barajasalfredo13/Cookie.Board.Variants/README.md

# Cookie Board Variants  
This is a subiteration of the cookie board design
Stencils were made to create protected layers  

⚠️ PCB Dimensions ⚠️  
- 0.8 mm Thickness  
::: ZIP Gerber Dimensions :::  
- Full Board Stencil Dimensions ::: [x; 61.034 y; 45.501] mm  
- Full Board Cookie Dimensions ::: [x; 40.6 y; 46.15] mm  

### ::: Base of the Cookie Board ::: ###  
-6x6 mm pad  
-0.5 mm and 1.0 mm graphic for trace displacement and design  
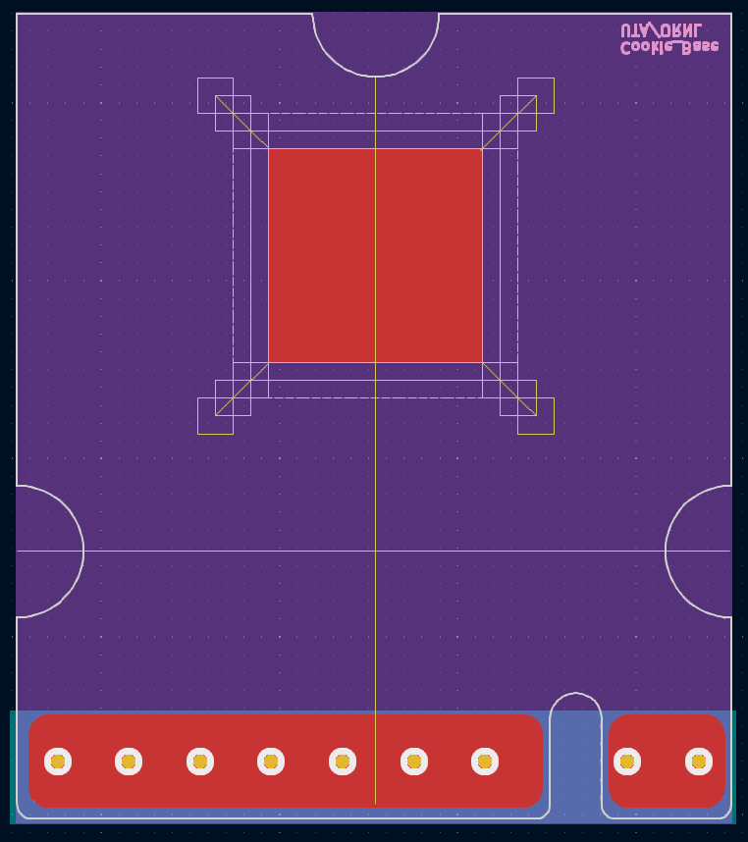
[picture p1: ReadMeImages/BoardBase.png]
 
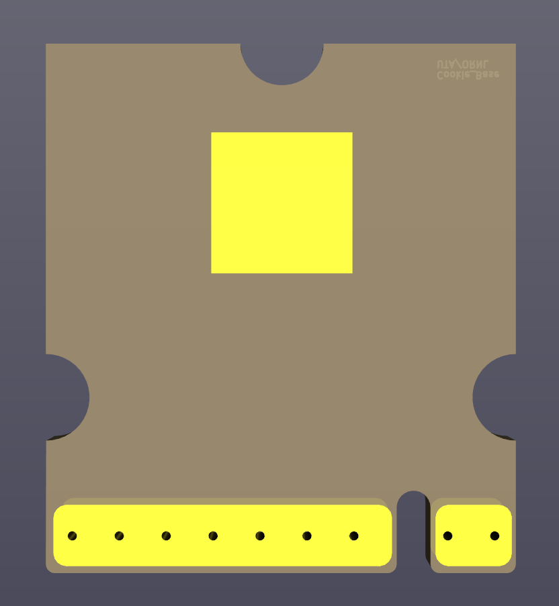
[picture p2: ReadMeImages/BoardBase2.png]
  

### ::: Variants of the Board ::: ###  
-All Boards 1.0 mm distance from pad  
-0.5 and 1.0 mm trace thickness variations  
-Square and L Variation  
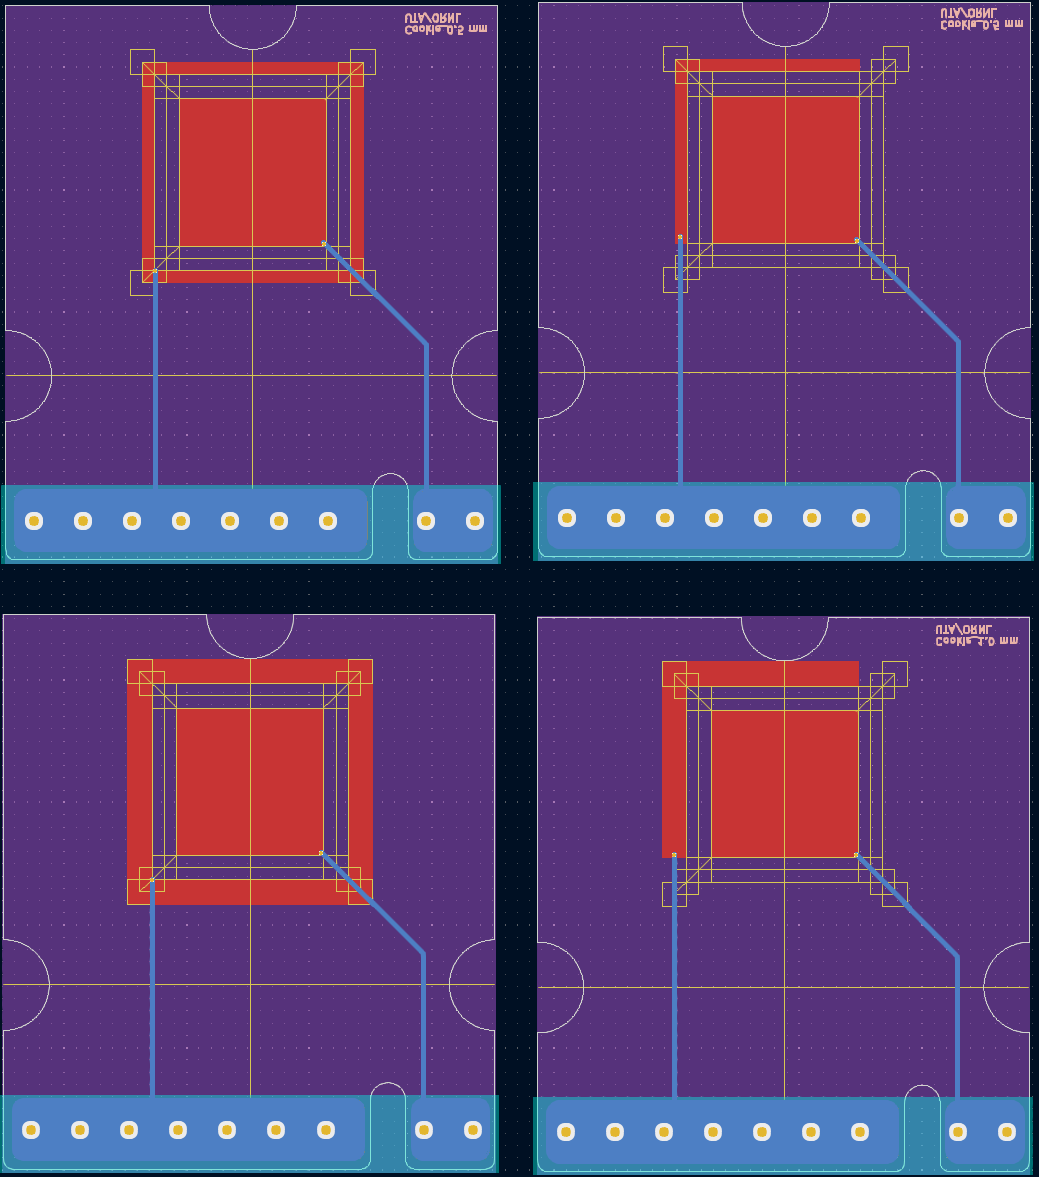
[picture p3: ReadMeImages/BoardVar.png]
 

### ::: PCB Stencils ::: ###  
-Stencils for coating were created per board variation  
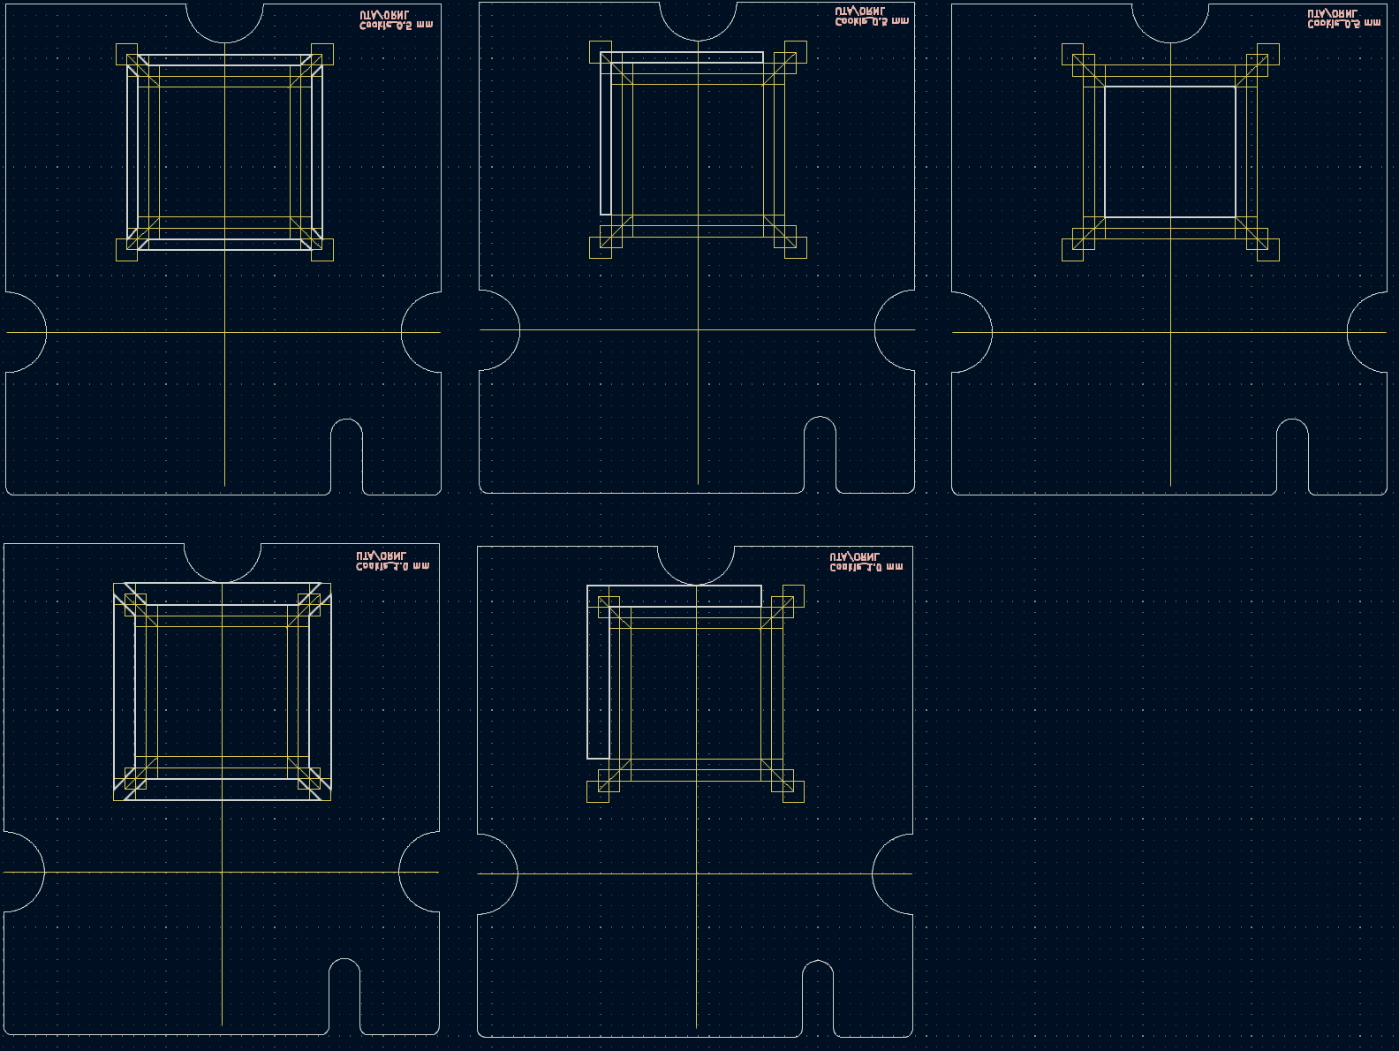
[picture p4: ReadMeImages/KiCadStencils1.png]
 
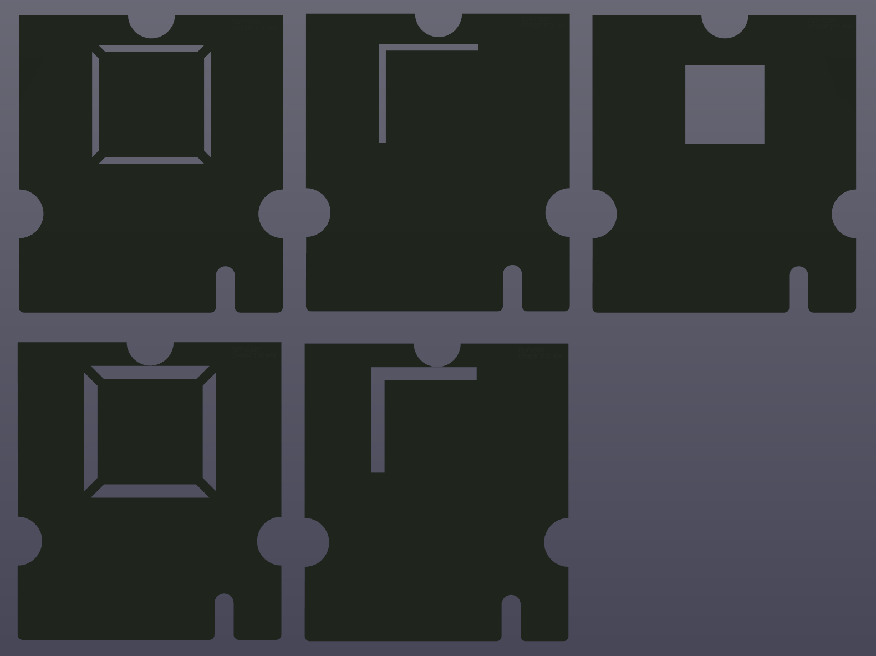
[picture p5: ReadMeImages/KiCadStencils2.png]
 
  
### ::: Sheet Metal Stencils ::: ###  
-Sheet Metal stencils were using PCB Step Files  
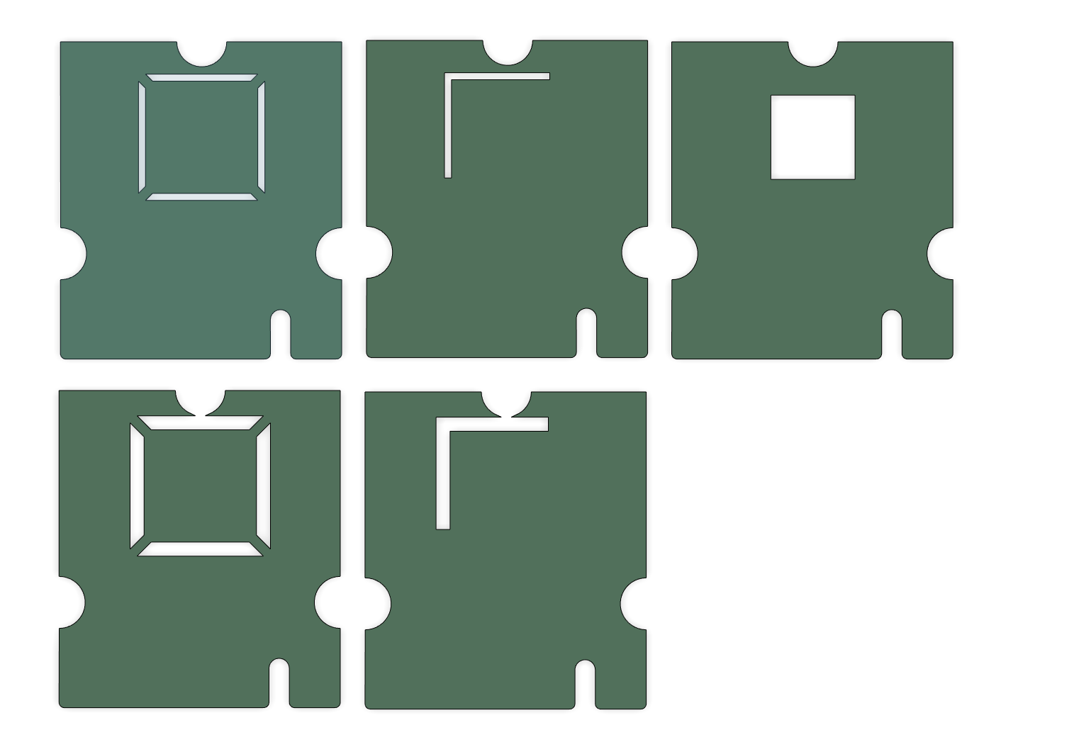
[picture p6: ReadMeImages/FusionStencils.png]
  
  
### ::: Stencil Holder ::: ###  
-Stencil Holder is used with PCB Stencils or Sheet Metal Stencils  
-2 Stencil Holders were made, one with wiggle room (gray) one with PCB Step Files (Green)  
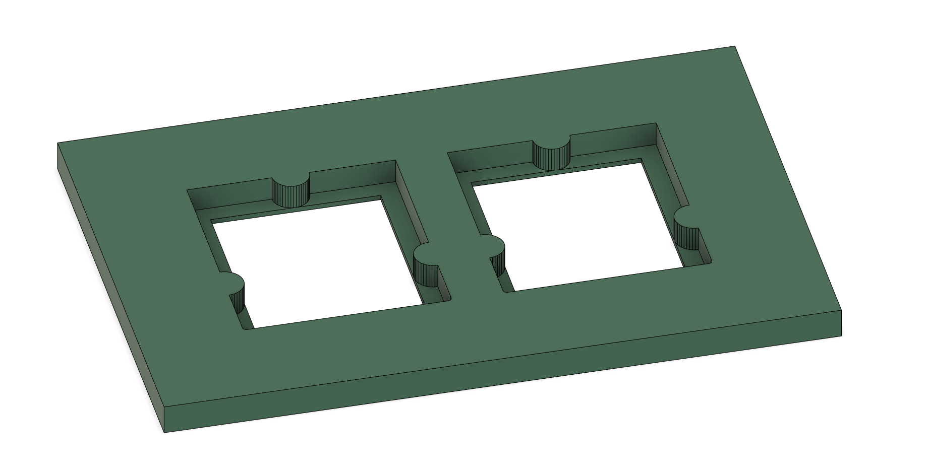
[picture p7: ReadMeImages/StencilHolder1.png]
  
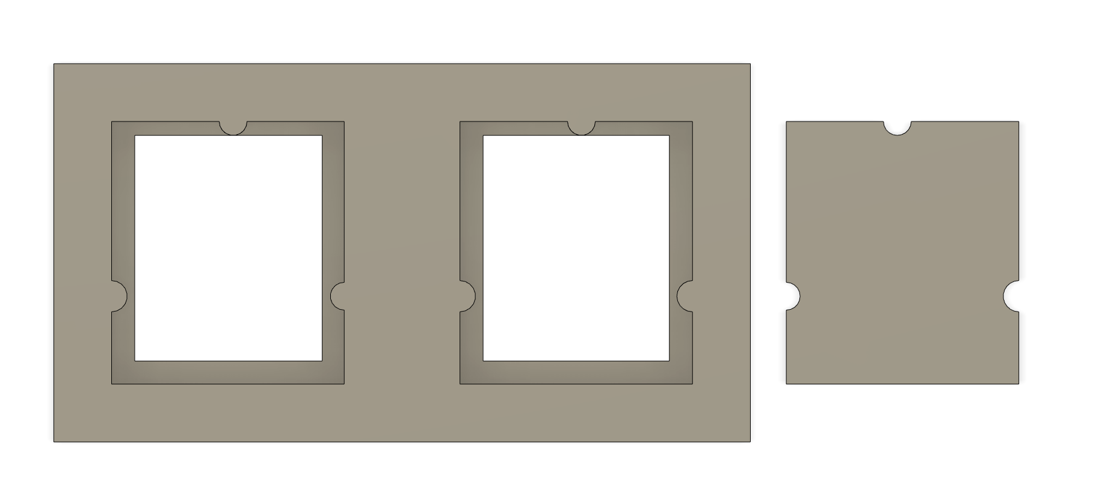
[picture p8: ReadMeImages/StencilHolder2.png]
