barajasalfredo13/Cookie.Board.Variants/ReadMeImages/MetalStencil.png

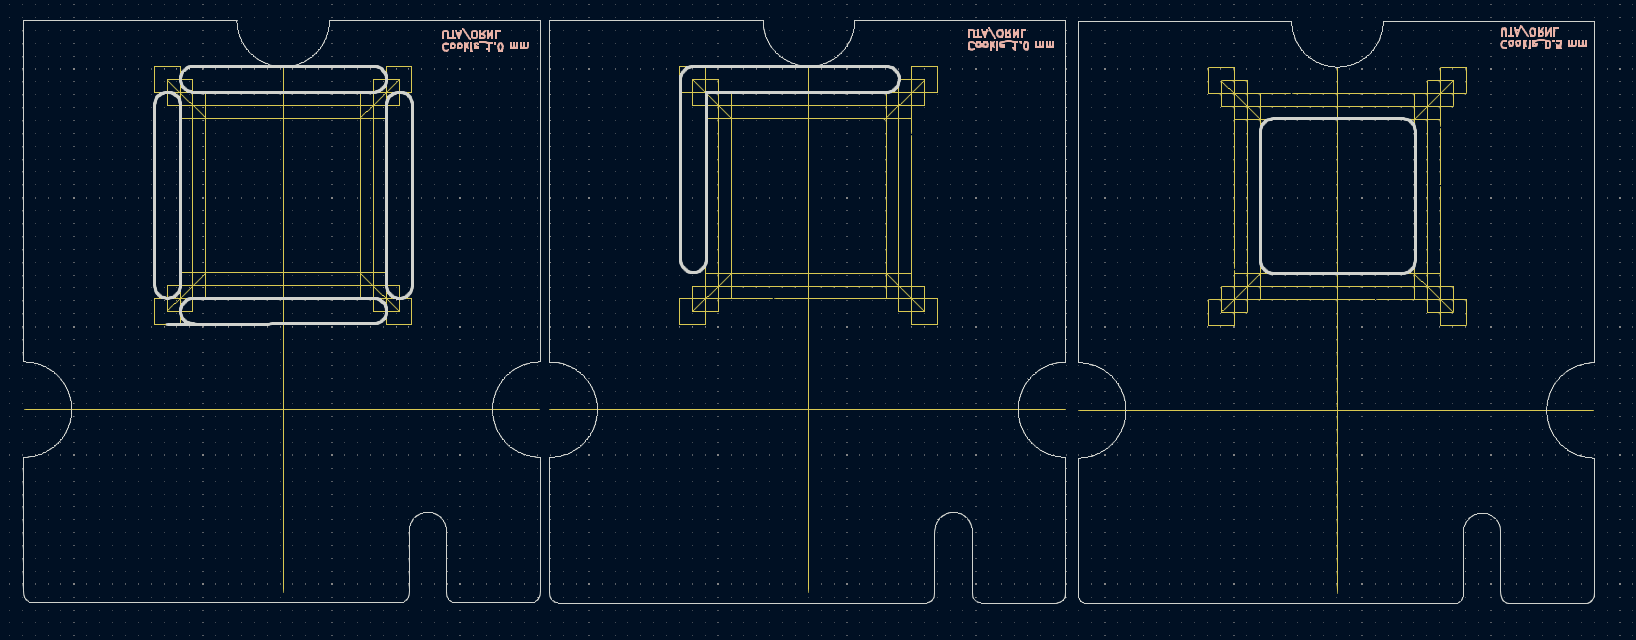
ReadMeImages/MetalStencil.png
