barajasalfredo13/Cookie.Board.Variants/ReadMeImages/StencilAddedMass.png

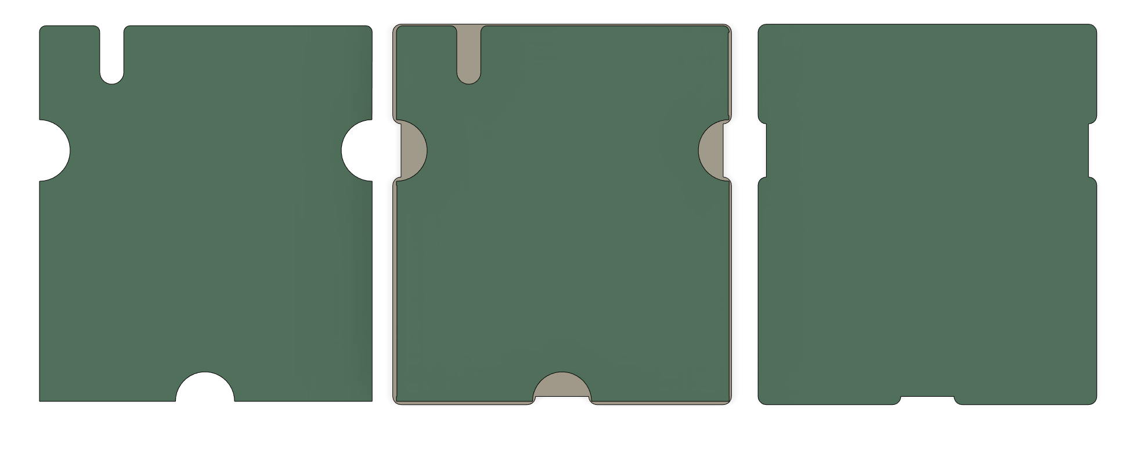
ReadMeImages/StencilAddedMass.png
