barajasalfredo13/Cookie.Board.Variants/4.DXF.Files/StencilHolder.dxf

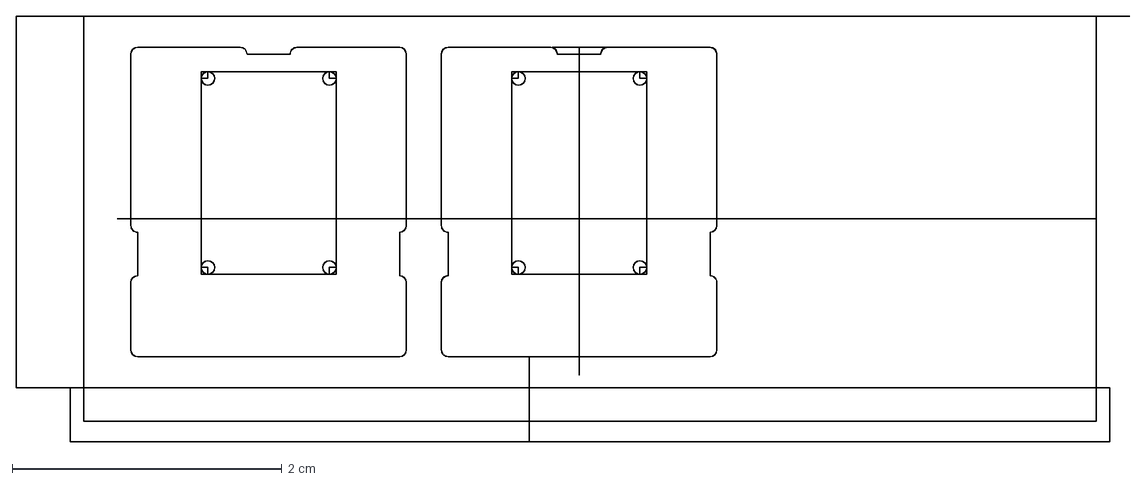
[picture p11: CAD file, 2023-04-19]
4.DXF.Files/StencilHolder.dxf
8.25 x 3.15 cm
