barajasalfredo13/Cookie.Board.Variants/4.DXF.Files/Cookie.Singlets.dxf

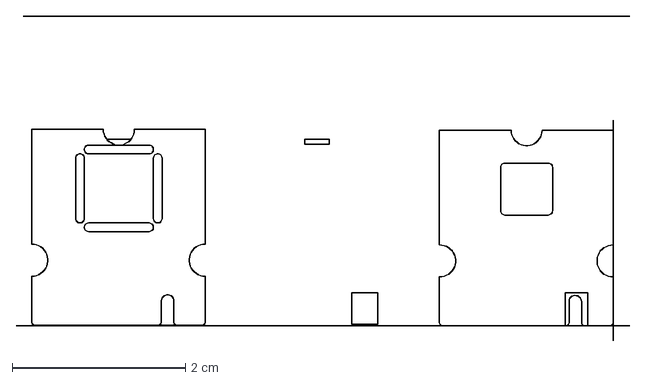
[picture p12: CAD file, 2023-04-19]
4.DXF.Files/Cookie.Singlets.dxf
7.08 x 3.75 cm
