barajasalfredo13/Cookie.Board.Variants/(list of files, cad)

Other CAD files:
2.Fusion360Files/1.Stencil.Holder/StencilHolder.f3d
2.Fusion360Files/2.Singlet.Stencils/Cookie_Singlets.f3d
