barajasalfredo13/Cookie.Board.Variants/2.Fusion360Files/2.Singlet.Stencils/SingletStencilsImperial.pdf

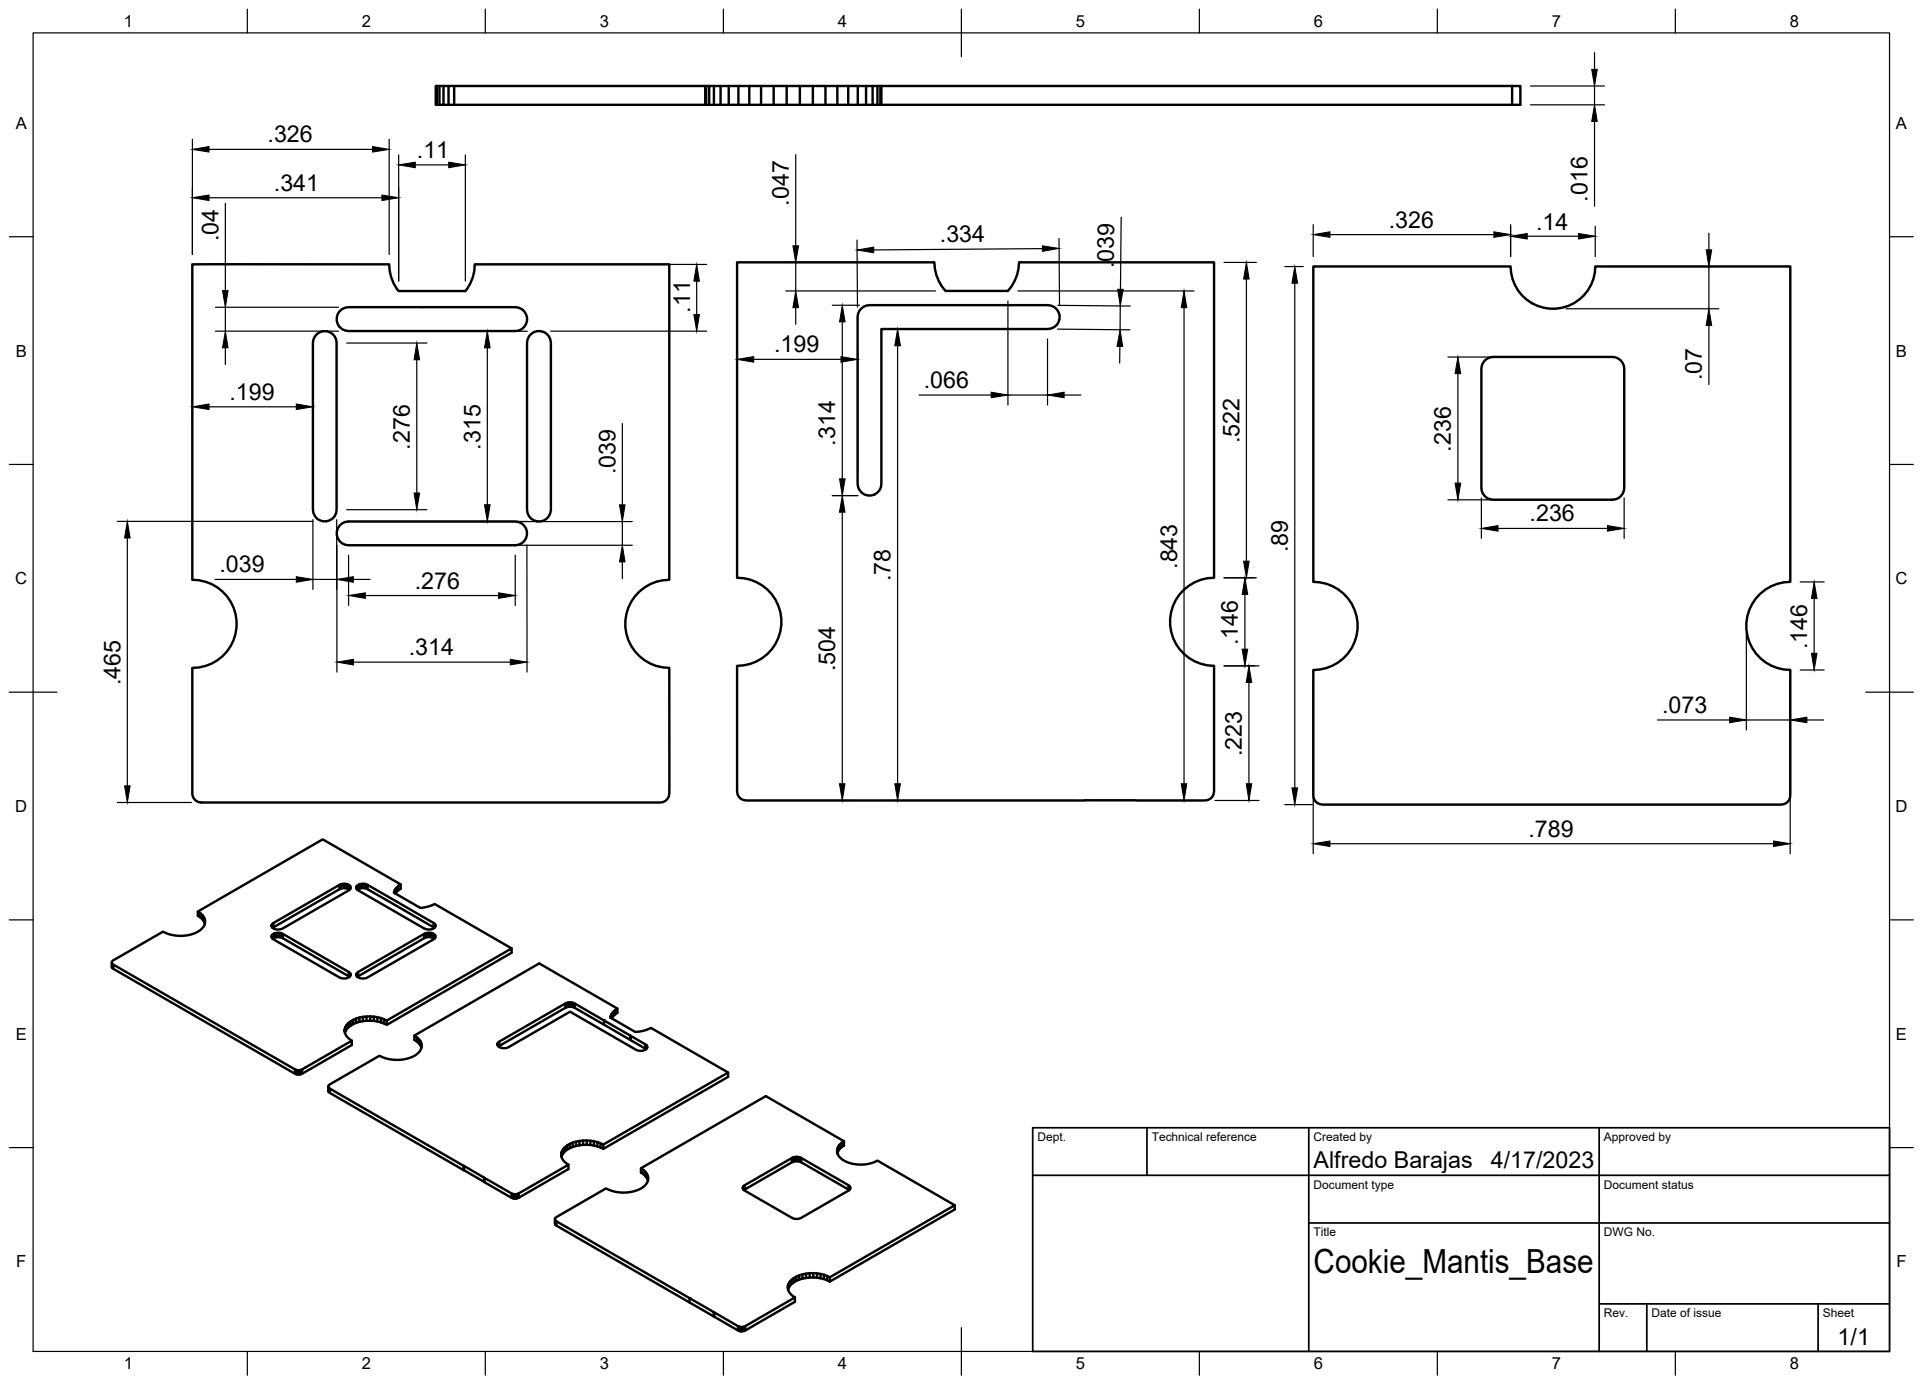
[picture p13: page 1]
Title; DWG No.; Rev.; Date of issue; Sheet

Dept. | Technical reference | Created by Alfredo Barajas 4/17/2023 | Approved by

Document type | Document status
