barajasalfredo13/Cookie.Board.Variants/2.Fusion360Files/1.Stencil.Holder/StencilHolderImperial.pdf

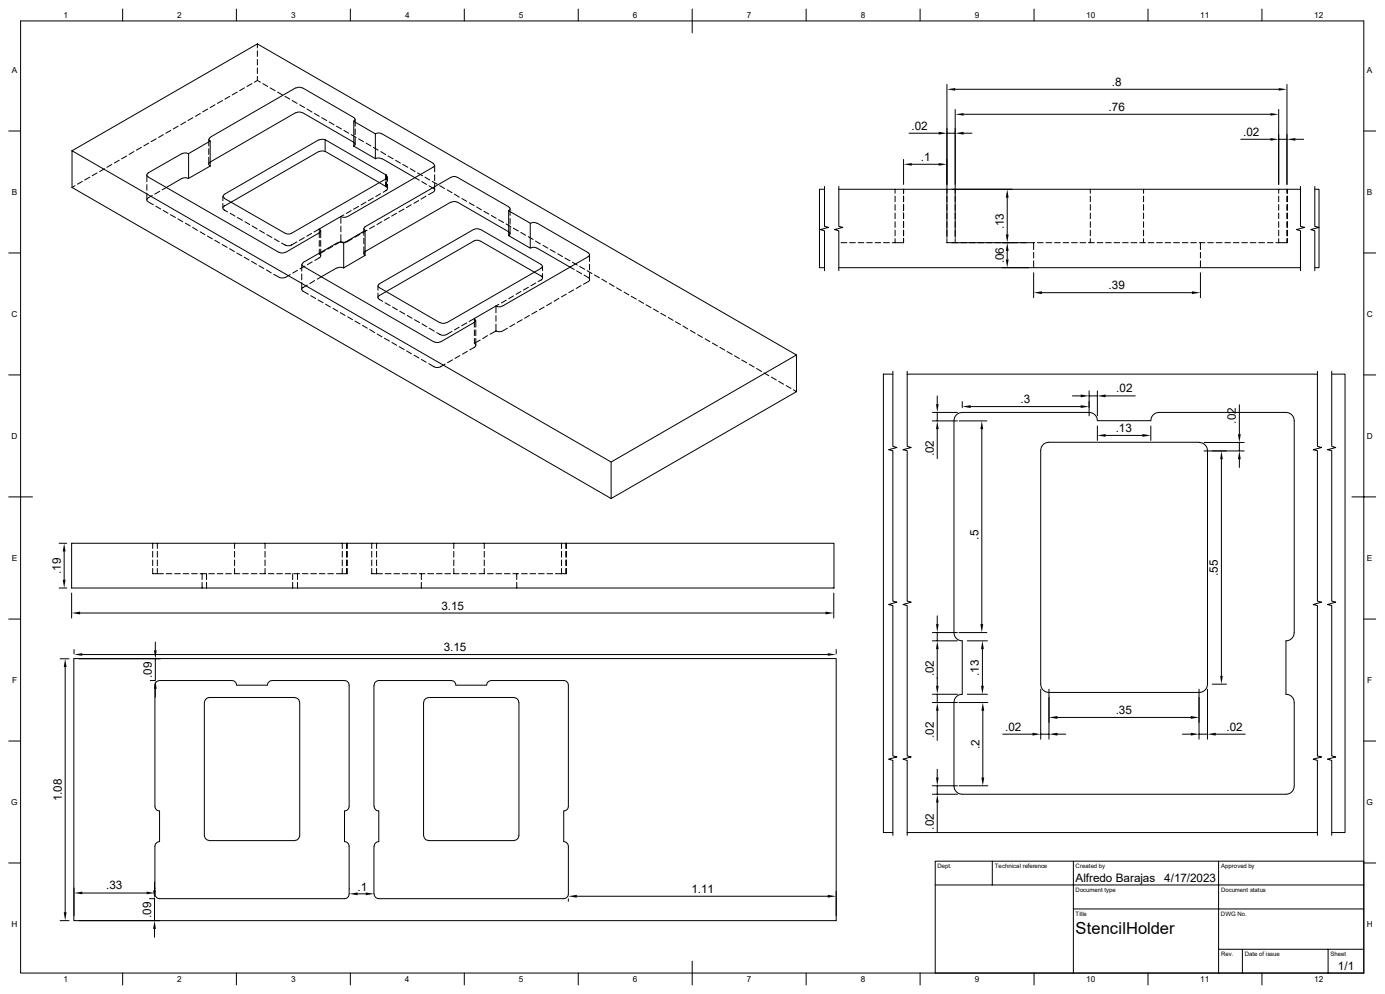
[picture p14: page 1]
Dept.; Technical reference; Created by; Approved by; Alfredo Barajas

Document type | Rev. Date of issue Sheet 4/17/2023 Document status

Title StencilHolder | DWG No.
