barajasalfredo13/Cookie.Board.Variants/(commit log)

2023-03-28 Added files to repository
    [aSe_Rooks_m.2.cookies_v3.kicad_pcb, aSe_Rooks_m.2.cookies_v3.kicad_sch, base_transform.kicad_pcb, prototype.variants.kicad_pcb]
2023-03-28 Updated Base File
    [base_transform.kicad_pcb]
2023-03-29 Updated Collection pad to 6x6. Created new base
    [aSe_Rooks_m.2.cookies_v3.kicad_pcb, aSe_Rooks_m.2.cookies_v3.kicad_sch, base_transform.kicad_pcb, prototype.variants.kicad_pcb]
2023-03-29 Updated Stencils and Mantis Boards
    [Cookie_Mantis.kicad_pcb, Cookie_Mantis_Stencil.kicad_pcb]
2023-03-29 Updated Files
    [Cookie_Mantis.kicad_pcb]
2023-03-30 Added Everything
    [Cookie_Mantis.kicad_pcb, Cookie_Mantis_Base.step, Cookie_Mantis_Stencil.kicad_pcb, Cookie_Mantis_Stencil.step, Cookie_Stencil_Holder.f3d, Cookie_Stencils.f3d, StencilHolder2.f3d, base_transform.kicad_pcb]
2023-03-30 Unionized Cookie and Stencil Boards
    [Cookie_Mantis.kicad_pcb, Cookie_Mantis_Stencil.kicad_pcb]
2023-03-30 Added Gerber Zipped and UnZipped Files
    [Cookie_Mantis-B_Cu.gbr, Cookie_Mantis-B_Mask.gbr, Cookie_Mantis-B_Paste.gbr, Cookie_Mantis-B_Silkscreen.gbr, Cookie_Mantis-Edge_Cuts.gbr, Cookie_Mantis-F_Cu.gbr, Cookie_Mantis-F_Mask.gbr, Cookie_Mantis-F_Paste.gbr]
2023-04-10 Edited Files for 1mm Drill Bit
    [Cookie_Stencil.kicad_pcb]
2023-04-14 Updated to blind vias
    [Cookie_Mantis-B_Cu.gbr, Cookie_Mantis-B_Mask.gbr, Cookie_Mantis-B_Paste.gbr, Cookie_Mantis-B_Silkscreen.gbr, Cookie_Mantis-Edge_Cuts.gbr, Cookie_Mantis-F_Cu.gbr, Cookie_Mantis-F_Mask.gbr, Cookie_Mantis-F_Paste.gbr]
2023-04-17 Updated Stencil and Holder files for 1 mm diameter drills
    [Cookie_Mantis_Base.step, Cookie_Mantis_Stencil.step, Cookie_Singlets.f3d, Cookie_Stencil.kicad_pcb, Cookie_Stencil_Holder.f3d, Cookie_Stencils.f3d, StencilHolder.f3d, StencilHolder2.f3d]
2023-04-17 Finished Stencil Holder Drawing
    [StencilHolder.f3d]
2023-04-19 Updated older models and regenerated fusion360 files. Generated DXF files
    [Cookie.Singlets.dxf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]
